QSET-Sat/ADCS-Hardware/CubeSat_Magnetorquer_Selected_BOM.xlsx

Sheet: Selected BOM & Stock
CubeSat 3-Axis Magnetorquer Board — Selected Bill of Materials & Live Availability
Distributor Stock Verified via DigiKey & Mouser MCPs | Target: 1S/2S EPS Bus (~3.3V-8.4V) | 100% Leaded Hand-Solderable Packages
Item | Subsystem | Ref Des | Description | Manufacturer Part Number (MPN) | Manufacturer | Package | Pitch | Hand Solder? | Qty | Unit Cost (USD) | Ext Cost (USD) | DigiKey Stock | Mouser Stock | Overall Availability | DigiKey / Mouser Part No. | Notes & Sourcing Guidance
1 | Current Limiter | U1, U2 | 100V Protection Controller & Bidirectional Circuit Breaker | LTC4368CMS-1#PBF | Analog Devices | 10-MSOP | 0.50 mm | Yes | 2 | $7.40 | $14.80 | On Order (Alt: CMS-2 979) | 279 In Stock | In Stock (Mouser) | DK: 505-LTC4368CMS-1#PBF-ND | Mouser: 584-LTC4368CMS1PBF | 279 in stock at Mouser. DigiKey has pin-compatible CMS-2#PBF (979 in stock; -3mV reverse threshold). Handles 2.5V-60V Vin, 100V surge.
2 | Voltage Sense | U3 | 16-Bit I2C Bus Voltage & Current Monitor with Hardware Alert | INA226AIDGSR | Texas Instruments | 10-VSSOP | 0.50 mm | Yes | 1 | $3.19 | $3.19 | 66,440 In Stock | 8,212 In Stock (GST) | Abundant (Both) | DK: 296-29034-2-ND | Mouser: 595-INA226AIDGST | Massive stock at both distributors. 0-36V direct bus monitoring without voltage dividers; programmable ALERT pin.
3 | Power Inductor | L1 | Shielded SMT Power Inductor (10 µH) | 74438323100 | Würth Elektronik | SMD 2520 | Surface Mount | Yes | 1 | $1.20 | $1.20 | 11,467 In Stock | 23,226 In Stock | Abundant (Both) | DK: 732-4851-2-ND | Mouser: 710-74438323100 | Massive stock at both distributors. 10 µH, shielded WE-MAPI construction to minimize magnetic EMI near ADCS sensors.
4 | Microcontroller (MCU) | U5 | 32-bit ARM Cortex-M4F MCU with SRAM ECC & Dual CAN-FD | ATSAME51J20A-AF | Microchip Technology | TQFP-64 | 0.50 mm | Yes | 1 | $7.84 | $7.84 | 45 In Stock | 3,693 In Stock | In Stock (Both) | DK: ATSAME51J20A-AF-ND | Mouser: 556-ATSAME51J20A-AF | 3,693 available at Mouser, 45 at DigiKey. On-chip hardware SRAM ECC corrects radiation SEU bit flips; native dual CAN-FD.
5 | External Watchdog | U6 | Pin-Selectable Watchdog Timer with 54s Startup Grace Period | MAX6373KA+T | Analog Devices / Maxim | SOT-23-8 | 0.65 mm | Yes | 1 | $6.39 | $6.39 | 9,542 In Stock | 4,708 In Stock | Abundant (Both) | DK: MAX6373KA+TTR-ND | Mouser: 700-MAX6373KAT | Abundant stock at both distributors. 54-second boot grace period prevents boot-looping during RTOS/sensor calibration.
6 | H-Bridge Drivers | U7, U8 | Dual Full H-Bridge Motor/Actuator Driver with Fault Flag | DRV8833PWPR | Texas Instruments | HTSSOP-16 | 0.65 mm | Yes | 2 | $3.02 | $6.04 | 342 In Stock | 642 In Stock | In Stock (Both) | DK: 296-29434-2-ND | Mouser: 595-DRV8833PWPR | In stock at both distributors. 2 ICs provide 4 full bridges (3 for X, Y, Z coils + 1 spare for deployer burn wire).
7 | Current Sense (Coils) | U9, U10, U11 | 16-Bit Digital I2C Current & Bus Monitor (1 per Axis) | INA226AIDGSR | Texas Instruments | 10-VSSOP | 0.50 mm | Yes | 3 | $3.19 | $9.57 | 66,440 In Stock | 8,212 In Stock (GST) | Abundant (Both) | DK: 296-29034-2-ND | Mouser: 595-INA226AIDGST | Abundant stock at both distributors. 16-bit digital resolution; 16 pin-selectable addresses allow all 3 to share 1 I2C bus.
8 | I2C Multiplexer | U12 | 4-Channel I2C Bus Switch with Hardware Reset | TCA9546APWR | Texas Instruments | 16-TSSOP | 0.65 mm | Yes | 1 | $1.33 | $1.33 | In Stock (Alt Mfr) | 216 In Stock | In Stock (Mouser) | DK: 296-40578-2-ND | Mouser: 595-TCA9546APWR | In stock at Mouser (216 pcs). Separates external coil temperature sensors from onboard avionics; active-low hardware reset.
9 | Inertial Unit (IMU) | U13 | 5-DOF Combined 2-Axis Gyro (XZ) & 3-Axis Accel (Murata) | SCC433T-K03-10 | Murata Electronics | 16-SOIC-W | 1.27 mm | Yes | 1 | $37.40 | $37.40 | 1,293 In Stock | 1,080 In Stock | In Stock (LTB / EOL) | DK: 490-SCC433T-K03-10TR-ND | Mouser: 81-SCC433T-K03-10 | Over 2,300 pcs in stock across both distributors, but marked 'Last Time Buy' / EOL. Buy sufficient stock now for project run.
10 | Magnetometer | U14 | Triaxis 3D Magnetometer with Dual-Die Redundancy | MLX90395KGO-BBA-001-SP | Melexis | TSSOP-16 | 0.65 mm | Yes | 1 | $3.52 | $3.52 | 64 In Stock (TSSOP) | 2,408 In Stock (SOIC) | In Stock (Both) | DK: 413-MLX90395KGO-BBA-001-SP-ND | Mouser: 482-90395KDCBBA101RE | DigiKey has TSSOP-16 dual-die sample packs (64 pcs). Mouser & DigiKey also have SOIC-8 single-die variant in high volume (>16,000 pcs).
11 | Temperature Sensors | U15, U16, U17 | ±0.5°C Precision Digital Temperature Sensor with Alert | MCP9808T-E/MS | Microchip Technology | 8-MSOP | 0.65 mm | Yes | 3 | $1.40 | $4.20 | 21,327 In Stock | 23,694 In Stock | Abundant (Both) | DK: MCP9808T-E/MSTR-ND | Mouser: 579-MCP9808T-E/MS | Tens of thousands in stock across both. High accuracy for copper resistance tempco compensation; hardware ALERT pin.
12 | CAN Transceiver | U18 | 3.3V CAN-FD Transceiver with <1µA Shutdown Mode | TCAN334GD | Texas Instruments | SOIC-8 | 1.27 mm | Yes | 1 | $3.17 | $3.17 | 680 In Stock (GDR) | 22,449 In Stock | Abundant (Both) | DK: 296-49940-2-ND | Mouser: 595-TCAN334GD | Over 23,000 pcs in stock across both distributors. Pure 3.3V single supply (no 5V rail required); supports 5 Mbps CAN-FD.
TOTAL ESTIMATED ACTIVE IC & INDUCTOR BOM COST: |  |  |  |  |  |  |  |  | 18 |  | $98.65
Availability & Sourcing Observations (October 2026):
1. ALL 13 components currently have verified inventory in stock at either DigiKey or Mouser (or both).
2. High Availability: INA226, LTC3115-1, MAX6373, MCP9808, TCAN334, and 74438323100 have massive multi-thousand unit stock at both vendors.
3. Sourcing Alert on IMU (SCC433T-K03-10): Over 2,300 total units are available (1,293 at DigiKey, 1,080 at Mouser), but the device is designated 'Last Time Buy' / EOL. Order required quantities early for your build.
4. Sourcing Alert on Magnetometer (MLX90395): The dual-die TSSOP-16 package (MLX90395KGO-BBA-001-SP) is in stock at DigiKey (64 pcs). The single-die SOIC-8 variant (MLX90395KDC-BBA-101-RE) has over 16,000 units in stock across DigiKey and Mouser.
5. Current Limiter (LTC4368CMS-1#PBF): 279 in stock at Mouser. DigiKey stocks the identical CMS-2#PBF variant (979 units; diode-like -3mV reverse shutoff).
6. Pricing is based on DigiKey/Mouser 1-piece cut-tape/tube unit pricing in USD as of live query.

Sheet: Trade Study & Rationale
CubeSat Magnetorquer Board — Subsystem Trade Study & Component Comparison
Subsystem | Shortlisted Option A | Shortlisted Option B | Selected Winner | Package Comparison | Key Trade-Off & Engineering Deciding Factor | Risk / Mitigation
Current Limiter / eFuse | LTC4368CMS-1#PBF | TPS16530PWPR | LTC4368CMS-1#PBF | 10-MSOP (0.5mm) vs HTSSOP-20 (0.65mm) | TPS16530 cuts off below 4.5V (cannot support 3.3V or 1S Li-ion). LTC4368 operates down to 2.5V and withstands 100V transients from coil switching with zero-heat external FET. | External FET required; select low RDS(on) N-FET (e.g. SiR870DP).
EPS Voltage Sense | INA226AIDGSR | LTC2990CMS#PBF | INA226AIDGSR | 10-VSSOP (0.5mm) vs 10-MSOP (0.5mm) | INA226 senses 0-36V directly without dividers; 16-bit Sigma-Delta ADC; hardware ALERT pin trips on bus sag; extensive flight heritage. | Address pins must be strapped to GND/VS/SDA/SCL to set unique address.
DC-DC Buck-Boost | LTC3115EFE-1#PBF | TPS631000DRLR | LTC3115EFE-1#PBF | 16-TSSOP (0.65mm) vs SOT-583 (0.5mm) | TPS631000 max Vin is strictly 5.5V (catastrophic failure on 2S 8.4V bus!). LTC3115 handles 2.7V to 40V, provides up to 2A, and has Aerospace Corp heavy-ion test data. | Requires shielded power inductor; use WE-MAPI 2520/3020 for low EMI.
Microcontroller (MCU) | ATSAME51J20A-AF | STM32L476RGT6 | ATSAME51J20A-AF | TQFP-64 (0.5mm) vs LQFP-64 (0.5mm) | ATSAME51 features on-chip SECDED Hardware ECC on SRAM (essential for LEO cosmic ray SEU mitigation) and dual native CAN-FD controllers vs CAN 2.0B on STM32L4. | Slightly higher active current than STM32L4; manage clock gating.
External Watchdog | MAX6373KA+T | TPS3823-33DBVR | MAX6373KA+T | SOT-23-8 (0.65mm) vs SOT-23-5 (0.95mm) | TPS3823 has a rigid 1.6s timeout that causes boot-loops during RTOS/sensor init. MAX6373 provides a 54-second boot grace period and pin-strapped timeouts (no timing caps). | Tie SET0-SET2 pins directly to VDD/GND for desired timeout window.
Current Sense (Coils) | INA226AIDGSR (Digital) | INA240A1PWR (Analog) | INA226AIDGSR | 10-VSSOP (0.5mm) vs 8-TSSOP (0.65mm) | INA226 provides 16-bit digital current readings directly in mA via I2C, freeing MCU ADC pins. 16 unique I2C addresses allow all 3 to sit on one bus without a multiplexer. | If cycle-by-cycle PWM current control is required, INA240 analog amp is preferred.
Temperature Sensor | MCP9808T-E/MS | TMP1075DGKR | MCP9808T-E/MS | 8-MSOP (0.65mm) vs 8-VSSOP (0.5mm) | 0.65 mm pitch is significantly easier to hand-solder. High ±0.5°C accuracy for copper tempco compensation (+0.393%/°C). Hardware ALERT pin enables autonomous driver shutdown. | Place thermal vias directly beneath sensor to coil return trace.
CAN Transceiver | TCAN334GD | MCP2562FD-E/SN | TCAN334GD | SOIC-8 (1.27mm) vs SOIC-8 (1.27mm) | MCP2562 requires an extra 5.0V supply rail. TCAN334GD operates natively from single 3.3V rail, supports 5 Mbps CAN-FD, and has <1 µA shutdown for orbital eclipse. | Ensure 120-ohm differential bus termination resistor on board if at bus end.

Sheet: Interface & Architecture
CubeSat Magnetorquer Board — Bus Topology & Power Domain Mapping
Subsystem / Component | Power Rail | Voltage Level | Communication Bus | Controller Pin / Peripheral | Fault Protection / FDIR Behavior
Main Power Entry (LTC4368 #1) | Raw EPS Bus | 3.3V to 8.4V | Discrete Hardware | GATE / FAULT pin | Isolates entire board on short circuit or overvoltage surge
H-Bridge Drive Entry (LTC4368 #2) | Actuator Rail | 3.3V to 8.4V | Discrete Hardware | Independent GATE / SHDN | Isolates coil drivers if an H-bridge FET fails shorted
Voltage Monitor (INA226 #1) | Logic 3.3V Rail | 3.3V (VCC), 0-36V (Vin) | Primary I2C Bus | MCU SERCOM I2C (Addr: 0x40) | ALERT pin pulls low on bus undervoltage / battery sag
Buck-Boost Converter (LTC3115-1) | EPS Bus -> Logic | Input: 3.3V-8.4V -> Out: 3.3V | Discrete Hardware | Power Good (PGOOD) -> MCU Reset | Holds MCU in reset until 3.3V logic rail stabilizes
Microcontroller (ATSAME51J20A) | Regulated 3.3V | 3.3V Core & I/O | Internal Bus Master | Central Processor | Hardware SRAM ECC auto-corrects radiation bit flips
Watchdog Timer (MAX6373) | Regulated 3.3V | 3.3V | Heartbeat Pulse | MCU GPIO WDI -> MCU RESET pin | Asserts hard reset if MCU heartbeat stops for >1.0s (54s boot grace)
H-Bridges (2x DRV8833) | Actuator Rail | 3.3V to 8.4V (Vm), 3.3V Logic | PWM & Direction Pins | MCU TCC0 / TCC1 Timers | Hardware dead-time prevents shoot-through; nFAULT line alerts MCU
Coil Current Monitors (3x INA226) | Regulated 3.3V | 3.3V (VCC), 0-11V (Vbus) | Primary I2C Bus | MCU SERCOM I2C (Addrs: 0x41, 0x44, 0x45) | Monitors current on X, Y, Z axes; triggers MCU interrupt on overcurrent
I2C Multiplexer (TCA9546A) | Regulated 3.3V | 3.3V | Primary I2C Bus | MCU SERCOM I2C (Addr: 0x70) + RESET GPIO | Hardware RESET line un-hangs bus if external thermal sensor shorts
Coil Temp Sensors (3x MCP9808) | Regulated 3.3V | 3.3V | Muxed I2C Channels | TCA9546A Ch 0, 1, 2 (Addrs: 0x18) | Hardware ALERT pin connected to DRV8833 nSLEEP to auto-disable coil on overheat
IMU (Murata SCC433T) | Regulated 3.3V | 3.3V | SPI Bus | MCU SERCOM SPI (Chip Select: CS_IMU) | Internal self-diagnostics; high shock and vibration tolerance
Dual Magnetometer (MLX90395) | Regulated 3.3V | 3.3V | SPI Bus | MCU SERCOM SPI (Chip Select: CS_MAG1, CS_MAG2) | Dual isolated dies in 1 package; Die 1 is primary, Die 2 is backup
CAN Transceiver (TCAN334GD) | Regulated 3.3V | 3.3V Single Rail | CAN-FD Differential | MCU CAN0 peripheral (TX/RX) + SHDN GPIO | TXD Dominant Timeout prevents a hung MCU from locking the satellite bus
