QSET-Sat/ADCS-Hardware/Satellite_Budget-ADCS_2026-2027.xlsx

Queen's Space Engineering Team 2026-2027
Matthew Mora Vargas
ADCS Subsystem Manager
Category | Item | Priority | Description / Specifics | Unit Price | Quantity | Sub-Total | Notes
MCU & Logic
 | Microcontroller (STM32L4 / F4) | 1 | STM32L496RGT6 | $17.43 | 1 | $17.43 | STM32L4 preferred for lower power
 | External Watchdog IC | 1 | MAX6369KA + T | $4.48 | 1 | $4.48 | Hardware watchdog, MCU-independent
 | MRAM Non-volatile Memory | 1 | MR10Q010 or MR25H10; SPI; rad-tolerant | $5.47 | 1 | $5.47 | Fault log retention across resets
 | CAN Transceiver | 1 | SN65HVD230 | 1.5 | 1 | 1.5 | STM32 CAN peripheral to bus interface
Power
 | 3.3V LDO Regulator | 1 | LM1117-3.3 | inquiry | 1 | inquiry | Local regulation for MCU and digital ICs
 | Bulk Decoupling Cap — 3.3V rail | 1 | 100 µF electrolytic | $1.92 | 2 | $3.84 | Near 3.3V input connector
 | Bulk Decoupling Cap — 5V rail | 1 | 100 µF electrolytic | $1.92 | 2 | $3.84 | Near 5V input connector
 | Bypass Cap — IC power pins | 1 | 100 nF ceramic 0603 | $1.31 | 20 | $26.20 | One per IC power pin. per ADCS-PWR-03
Sensors
 | 6-axis IMU (gyro + accel) | 1 | ICM-42688-P | $14.33 | 1 | $14.33 | Angular rate ±500 deg/s. detumbling + attitude
 | 3-axis Magnetometer | 1 | LIS3MDL | $12.32 | 1 | $12.32 | Earth B-field ref. keep away from magnetorquer traces
 | Sun Sensor Photodiode | 1 | BPW34 | $2.91 | 4 | $11.64 | One per face (+X −X +Y −Y) via TIA on sensor board
 | Transimpedance Amplifier | 1 | OPA2134PA-ND | $14.46 | 4 | $57.84 | Photodiode current to voltage on sensor daughterboard
 | Tether Current Sensor | 1 | ACS712 | $6.03 | 1 | $6.03 | Measures tether current for Lorentz disturbance estimate
 | Magnetorquer Current Sense | 1 | INA180A4IDBVR IC | $0.74 | 3 | $2.22 | One per magnetorquer axis power monitoring
Actuators
 | Custom-Built Magnetorquers | 1 |  | N/A | 1 | N/A | Only one magnetorquer rod will be used for the FlatSat
 | Magnetorquer H-bridge Driver | 1 | DRV8833CPWPR | $3.50 | 3 | 10.5 | One IC per axis. PWM current control
Connectors
 | PC104 Stack-through Connector | 1 | Mouser PC104 2.54mm | $1.05 | 1 | 1.05 | 3.3V + 5V power, CAN bus, tether status from EPS
 | Sensor Board Connector | 1 | Harwin M20-7821446-ND | $2.63 | 1 | 2.63 | Interface to sensor interface daughterboard
 | Magnetorquer Connector | 1 | Molex WM3264-ND | $2.50 | 1 | 2.5 | Power + PWM + direction to magnetorquer board
 | Tether Power / Signal Connector | 1 | Molex WM1784-ND | $0.67 | 1 | 0.67 | Tether current sense + deployment status signals
Total |  |  |  |  |  | $184.49
