QSET-Sat/ADCS-Hardware/(commit log)

2026-10-12 Initial commit.
    [ADCS_Magnetorquer_Board.kicad_pcb, ADCS_Magnetorquer_Board.kicad_sch, Actuator.kicad_sch, CubeSat_Magnetorquer_Selected_BOM.xlsx, Processing.kicad_sch, Sensing.kicad_sch]
2026-10-24 Added actuation circuit for x, y, and z axes
    [ADCS_Magnetorquer_Board.kicad_sch, Actuator.kicad_sch, Processing.kicad_sch, Sensing.kicad_sch]
2026-10-24 Added debug schematic sheet and ST-Link 14 pin header
    [ADCS_Magnetorquer_Board.kicad_sch, Debug.kicad_sch, Sensing.kicad_sch]
2026-10-25 Formatting changes
    [ADCS_Magnetorquer_Board.kicad_sch, Actuator.kicad_sch, CubeSat_Magnetorquer_Selected_BOM.xlsx, Processing.kicad_sch, Sensing.kicad_sch]
2026-11-06 Added the CAN communication IC suggested by the OBC team.
    [ADCS_Magnetorquer_Board.kicad_sch, Debug.kicad_sch]
2026-11-07 Add telemetry sheet and update MCU symbols
    This change adds the new Telemetry sheet and the ICM-42688-P symbol library, and connects SWDIO/SWCLK pins through the design hierarchy. It also refreshes project metadata for the current KiCad version and updates MCU, LED, capacitor, and power symbol definitions in the Processing and Debug schematics.
    [ADCS_Magnetorquer_Board.kicad_sch, Debug.kicad_sch, Processing.kicad_sch, Telemetry.kicad_sch]
2026-11-08 Add .gitignore and untrack generated KiCad files
    Ignore per-user/transient KiCad state (*.kicad_prl, lock files, autosaves, Local History, backup archives and crash-recovery folders) plus OS/editor junk.
    Also stops tracking files that were already committed but are regenerated automatically. The .history gitlink is removed from the index: it was committed as a submodule pointer without a .gitmodules file, so it resolved to a broken empty submodule on clone. Files remain on disk.
    [ADCS_Magnetorquer_Board.kicad_sch, Actuator.kicad_sch, Processing.kicad_sch, Sensing.kicad_sch]
2026-11-08 Added efuse component to sensing page.
    [Sensing.kicad_sch]
